shimniok/bot-thoughts-sharpi2c/README.md

A2D converts analog for you and presents it digitally through I2C, SPI or Serial. 
The onboard ATtiny performs oversampling and filtering to reduce noise. Flexible and hackable, 
you can program the device with AVRISP and make use of any of the exposed GPIO pins.
