shimniok/bot-thoughts-sharpi2c/(list of files, cad)

Other CAD files:
i2c_adc/I2C_adc.skp
