shimniok/bot-thoughts-sharpi2c/sharpirfilter/SharpIR Filt.brd

## EAGLE design sharpirfilter/SharpIR Filt.brd (2015-05-10)

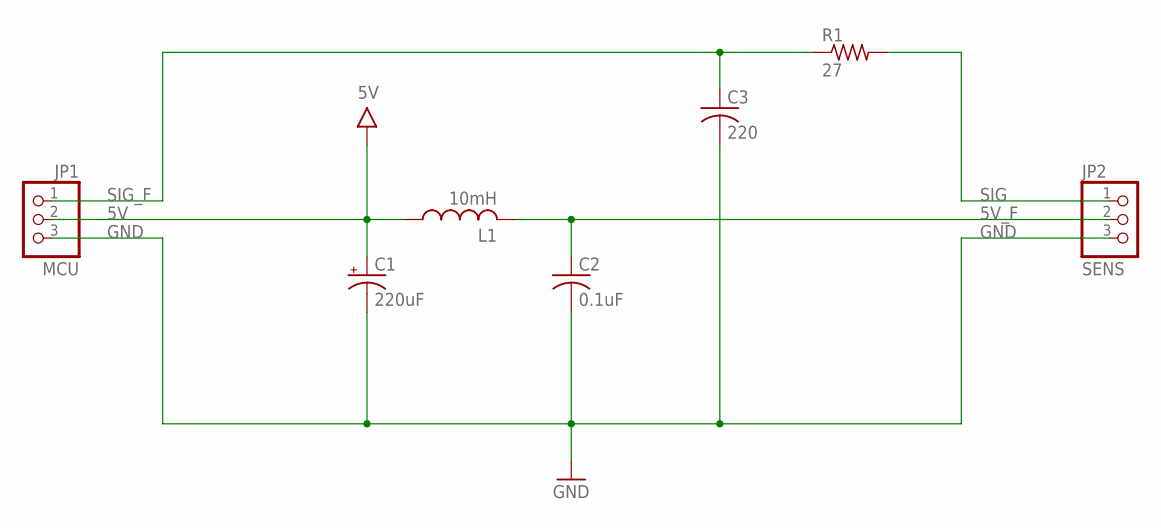
[picture p1: schematic SharpIR Filt.sch]

Parts:
C1: 220uF; PANASONIC_C
C2: 0.1uF; C0603
C3: 220; C0603
JP1: MCU; 1X03M
JP2: SENS; 1X03M
L1: 10mH; L5650M
R1: 27; R0603

Connections:
5V: C1.+, JP1.2, L1.1
5V_F: C2.1, JP2.2, L1.2
GND: C1.-, C2.2, C3.2, JP1.3, JP2.3
SIG: JP2.1, R1.2
SIG_F: C3.1, JP1.1, R1.1

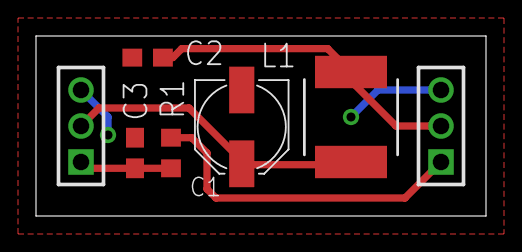
[picture p2: board SharpIR Filt.brd from above]

Board: 2 copper layers, 25.0 x 10.0 mm, 7 parts (0 on the bottom side), 5 nets.
