shimniok/bot-thoughts-sharpi2c/i2c_adc/i2c_adc_avr.brd

## EAGLE design i2c_adc/i2c_adc_avr.brd (2015-05-10)

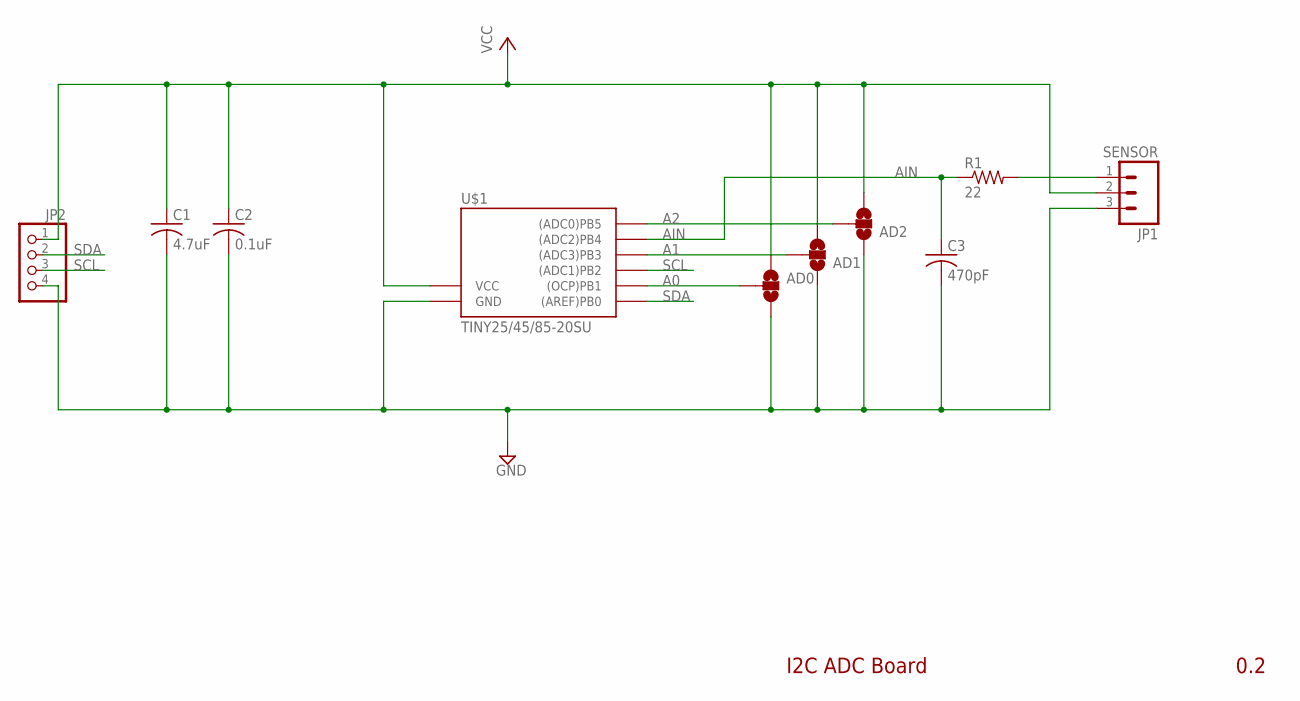
[picture p3: schematic i2c_adc_avr.sch]

Parts:
AD0, AD1, AD2: SOLDERJUMPER_2WAYS; SJ_3
C1: 4.7uF; C0603
C2: 0.1uF; C0603
C3: 470pF; C0603
JP1: SENSOR; 1X03
JP2: PINHD-1X04_2.54-S; 1X04-S
R1: 22; R0603
U$1: TINY25/45/85-20SU; SOIC8

Connections:
A0: AD0.2, U$1.6 ((OCP)PB1)
A1: AD1.2, U$1.2 ((ADC3)PB3)
A2: AD2.2, U$1.1 ((ADC0)PB5)
AIN: C3.1, R1.1, U$1.3 ((ADC2)PB4)
GND: AD0.3, AD1.1, AD2.1, C1.2, C2.2, C3.2, JP1.3, JP2.4, U$1.4 (GND)
unnamed: JP1.1, R1.2
SCL: JP2.3, U$1.7 ((ADC1)PB2)
SDA: JP2.2, U$1.5 ((AREF)PB0)
VCC: AD0.1, AD1.3, AD2.3, C1.1, C2.1, JP1.2, JP2.1, U$1.8 (VCC)

Notes on the sheet:
I2C ADC Board
0.2

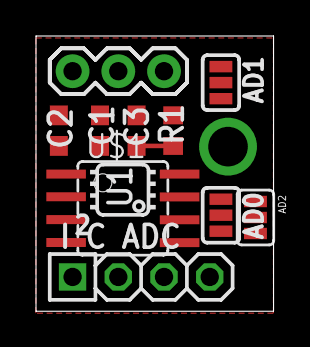
[picture p4: board i2c_adc/i2c_adc_avr.brd from above]

Board: 2 copper layers, 13.2 x 15.3 mm, 10 parts (0 on the bottom side), 9 nets.
