shimniok/bot-thoughts-sharpi2c/i2c_adc/i2c_adc_1.brd

## EAGLE design i2c_adc/i2c_adc_1.brd (2015-05-10)

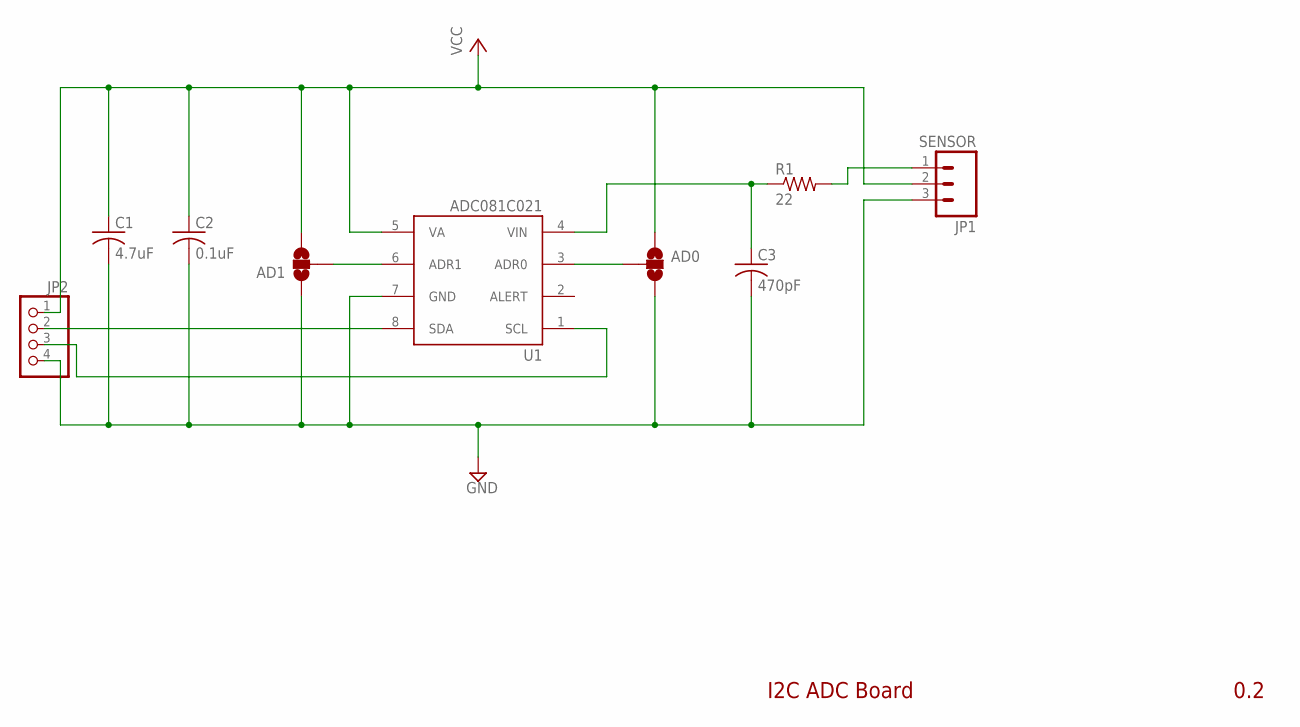
[picture p5: schematic i2c_adc_1.sch]

Parts:
AD0, AD1: SOLDERJUMPER_2WAYS; SJ_3
C1: 4.7uF; C0603
C2: 0.1uF; C0603
C3: 470pF; C0603
JP1: SENSOR; 1X03
JP2: PINHD-1X04_2.54-S; 1X04-S
R1: 22; R0603
U1: ADC081C021; MSOP8_0.65

Connections:
GND: AD0.3, AD1.1, C1.2, C2.2, C3.2, JP1.3, JP2.4, U1.7 (GND)
unnamed: JP1.1, R1.2
unnamed: AD1.2, U1.6 (ADR1)
unnamed: AD0.2, U1.3 (ADR0)
unnamed: C3.1, R1.1, U1.4 (VIN)
SCL: JP2.3, U1.1 (SCL)
SDA: JP2.2, U1.8 (SDA)
VCC: AD0.1, AD1.3, C1.1, C2.1, JP1.2, JP2.1, U1.5 (VA)

Notes on the sheet:
I2C ADC Board
0.2

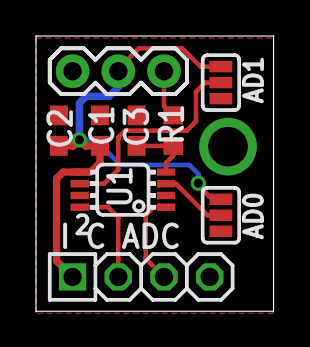
[picture p6: board i2c_adc_1.brd from above]

Board: 2 copper layers, 13.2 x 15.3 mm, 9 parts (0 on the bottom side), 8 nets.
