shimniok/bot-thoughts-sharpi2c/electronics/backplane.brd

## EAGLE design electronics/backplane.brd (2013-08-21)

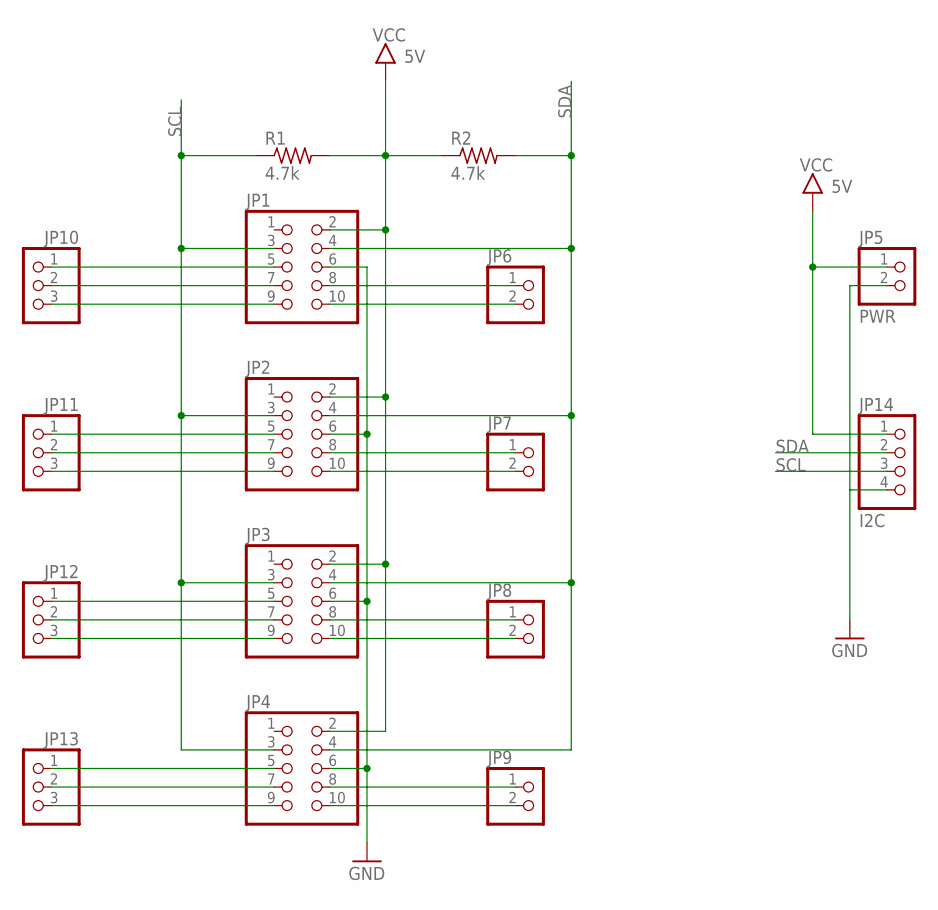
[picture p7: schematic backplane.sch]

Parts:
JP1, JP2, JP3, JP4: PINHD-2X5; 2X05
JP5: PWR; 1X02-S
JP6, JP7, JP8, JP9: PINHD-1X02_2.54-S; 1X02-S
JP10, JP11, JP12, JP13: PINHD-1X03_2.54-S; 1X03-S
JP14: I2C; 1X04-S
R1, R2: 4.7k; R0603

Connections:
GND: JP1.6, JP2.6, JP3.6, JP4.6, JP5.2, JP14.4
unnamed: JP1.5, JP10.1
unnamed: JP1.7, JP10.2
unnamed: JP1.9, JP10.3
unnamed: JP1.8, JP6.1
unnamed: JP2.5, JP11.1
unnamed: JP2.7, JP11.2
unnamed: JP2.9, JP11.3
unnamed: JP3.5, JP12.1
unnamed: JP3.7, JP12.2
unnamed: JP3.9, JP12.3
unnamed: JP4.5, JP13.1
unnamed: JP4.7, JP13.2
unnamed: JP4.9, JP13.3
unnamed: JP1.10, JP6.2
unnamed: JP2.8, JP7.1
unnamed: JP2.10, JP7.2
unnamed: JP3.8, JP8.1
unnamed: JP3.10, JP8.2
unnamed: JP4.8, JP9.1
unnamed: JP4.10, JP9.2
SCL: JP1.3, JP2.3, JP3.3, JP4.3, JP14.3, R1.1
SDA: JP1.4, JP2.4, JP3.4, JP4.4, JP14.2, R2.2
VCC: JP1.2, JP2.2, JP3.2, JP4.2, JP5.1, JP14.1, R1.2, R2.1

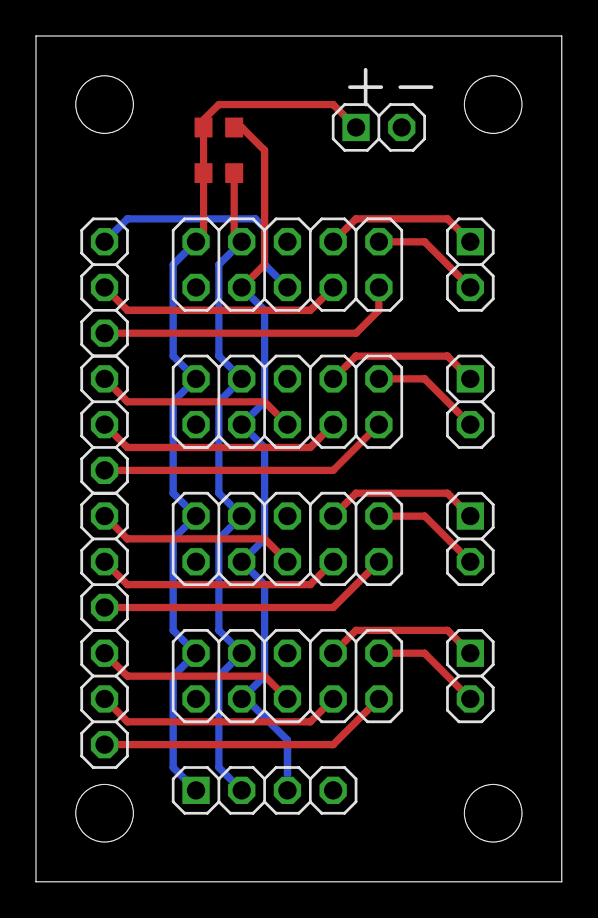
[picture p8: board backplane.brd from above]

Board: 2 copper layers, 29.2 x 47.0 mm, 16 parts (0 on the bottom side), 24 nets.
