shimniok/bot-thoughts-sharpi2c/electronics/i2c_adc_avr_inline_soic_pth.brd

## EAGLE design electronics/i2c_adc_avr_inline_soic_pth.brd (2013-08-21)

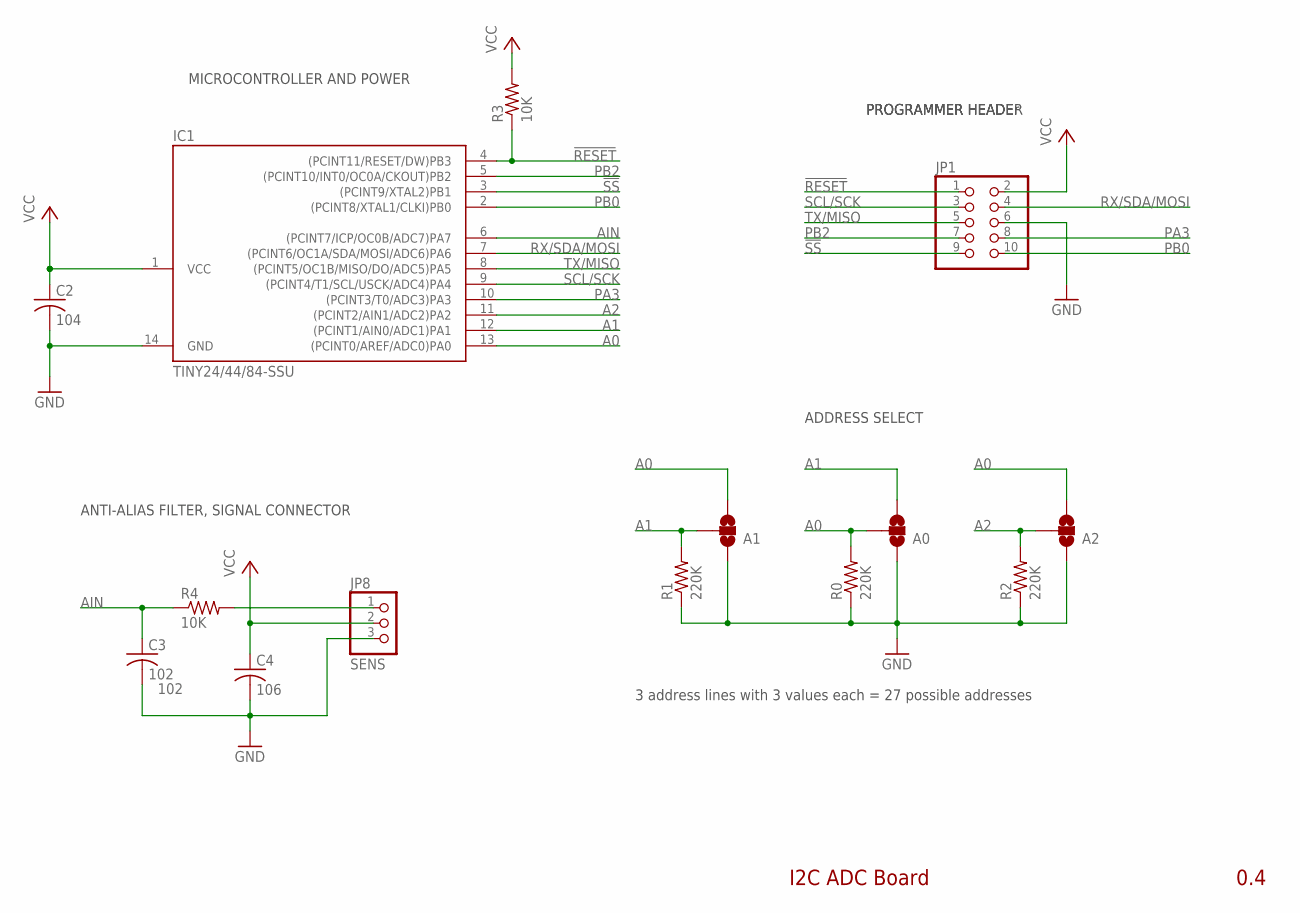
[picture p9: schematic i2c_adc_avr_inline_soic_pth.sch]

Parts:
A0, A1, A2: SJ_3
C2: 104; C0603; PARTNO C1608X7R1E104K080AA
C3: 102; C0603; PARTNO CL10B102KB8SFNC
C4: 106; C0603; PARTNO CL10A106MP8NNNC
IC1: TINY24/44/84-SSU; SOIC14
JP1: PINHD-2X05_2.54-90°; 2X05/90
JP8: SENS; 1X03-S
R0, R1, R2: 220K; R0603; PARTNO RC1608J224CS
R3, R4: 10K; R0603; PARTNO 1622829-1

Connections:
!RESET: IC1.4 ((PCINT11/RESET/DW)PB3), JP1.1, R3.1
!SS: IC1.3 ((PCINT9/XTAL2)PB1), JP1.9
A0: A0.2, A1.3, A2.3, IC1.13 ((PCINT0/AREF/ADC0)PA0), R0.2
A1: A0.3, A1.2, IC1.12 ((PCINT1/AIN0/ADC1)PA1), R1.2
A2: A2.2, IC1.11 ((PCINT2/AIN1/ADC2)PA2), R2.2
AIN: C3.1, IC1.6 ((PCINT7/ICP/OC0B/ADC7)PA7), R4.1
GND: A0.1, A1.1, A2.1, C2.2, C3.2, C4.2, IC1.14 (GND), JP1.6, JP8.3, R0.1, R1.1, R2.1
unnamed: JP8.1, R4.2
PA3: IC1.10 ((PCINT3/T0/ADC3)PA3), JP1.8
PB0: IC1.2 ((PCINT8/XTAL1/CLKI)PB0), JP1.10
PB2: IC1.5 ((PCINT10/INT0/OC0A/CKOUT)PB2), JP1.7
RX/SDA/MOSI: IC1.7 ((PCINT6/OC1A/SDA/MOSI/ADC6)PA6), JP1.4
SCL/SCK: IC1.9 ((PCINT4/T1/SCL/USCK/ADC4)PA4), JP1.3
TX/MISO: IC1.8 ((PCINT5/OC1B/MISO/DO/ADC5)PA5), JP1.5
VCC: C2.1, C4.1, IC1.1 (VCC), JP1.2, JP8.2, R3.2

Notes on the sheet:
I2C ADC Board
0.4
ADDRESS SELECT
MICROCONTROLLER AND POWER
ANTI-ALIAS FILTER, SIGNAL CONNECTOR
3 address lines with 3 values each = 27 possible addresses
PROGRAMMER HEADEr
PROGRAMMER HEADER

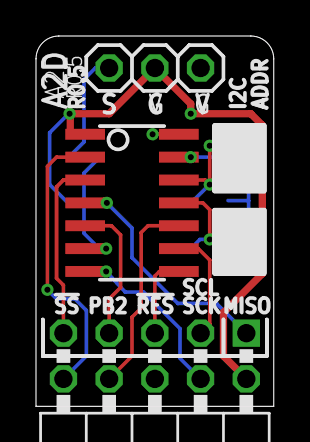
[picture p10: board i2c_adc_avr_inline_soic_pth.brd from above]

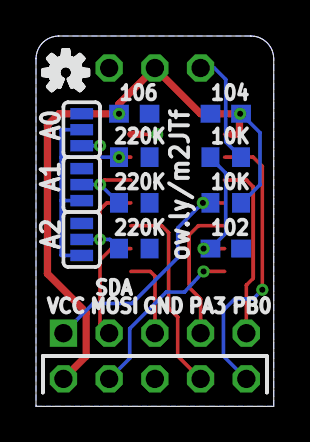
[picture p11: board i2c_adc_avr_inline_soic_pth.brd from below]

Board: 2 copper layers, 13.2 x 20.6 mm, 14 parts (11 on the bottom side), 15 nets.
