shimniok/bot-thoughts-sharpi2c/electronics/i2c_adc_avr_inline_soic.brd

## EAGLE design electronics/i2c_adc_avr_inline_soic.brd (2013-08-21)

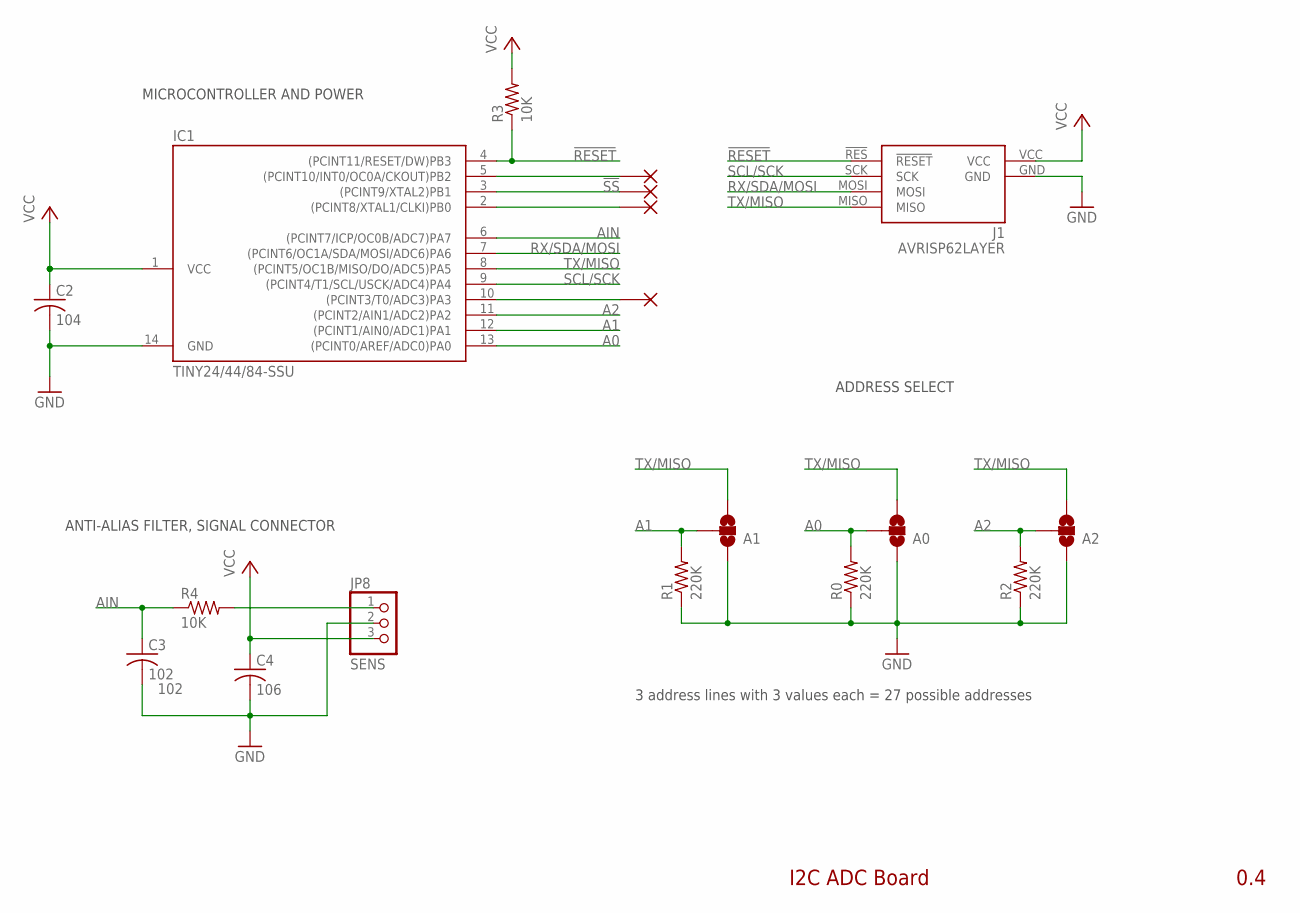
[picture p12: schematic i2c_adc_avr_inline_soic.sch]

Parts:
A0, A1, A2: SJ_3
C2: 104; C0603; PARTNO C1608X7R1E104K080AA
C3: 102; C0603; PARTNO CL10B102KB8SFNC
C4: 106; C0603; PARTNO CL10A106MP8NNNC
IC1: TINY24/44/84-SSU; SOIC14
J1: AVRISP62LAYER; 2X3_2LAYER
JP8: SENS; 1X03-S
R0, R1, R2: 220K; R0603; PARTNO RC1608J224CS
R3, R4: 10K; R0603; PARTNO 1622829-1
X1: PB2; PAD0.07X0.15
X2: !SS; PAD0.07X0.15
X3: PB0; PAD0.07X0.15
X4: PA3; PAD0.07X0.15

Connections:
!RESET: IC1.4 ((PCINT11/RESET/DW)PB3), J1.!RES (!RESET), R3.1
!SS: IC1.3 ((PCINT9/XTAL2)PB1), X2.P$1
A0: A0.2, IC1.13 ((PCINT0/AREF/ADC0)PA0), R0.2
A1: A1.2, IC1.12 ((PCINT1/AIN0/ADC1)PA1), R1.2
A2: A2.2, IC1.11 ((PCINT2/AIN1/ADC2)PA2), R2.2
AIN: C3.1, IC1.6 ((PCINT7/ICP/OC0B/ADC7)PA7), R4.1
GND: A0.1, A1.1, A2.1, C2.2, C3.2, C4.2, IC1.14 (GND), J1.GND, JP8.2, R0.1, R1.1, R2.1
unnamed: JP8.1, R4.2
unnamed: IC1.10 ((PCINT3/T0/ADC3)PA3), X4.P$1
unnamed: IC1.2 ((PCINT8/XTAL1/CLKI)PB0), X3.P$1
unnamed: IC1.5 ((PCINT10/INT0/OC0A/CKOUT)PB2), X1.P$1
RX/SDA/MOSI: IC1.7 ((PCINT6/OC1A/SDA/MOSI/ADC6)PA6), J1.MOSI
SCL/SCK: IC1.9 ((PCINT4/T1/SCL/USCK/ADC4)PA4), J1.SCK
TX/MISO: A0.3, A1.3, A2.3, IC1.8 ((PCINT5/OC1B/MISO/DO/ADC5)PA5), J1.MISO
VCC: C2.1, C4.1, IC1.1 (VCC), J1.VCC, JP8.3, R3.2

Notes on the sheet:
I2C ADC Board
0.4
ADDRESS SELECT
MICROCONTROLLER AND POWER
ANTI-ALIAS FILTER, SIGNAL CONNECTOR
3 address lines with 3 values each = 27 possible addresses

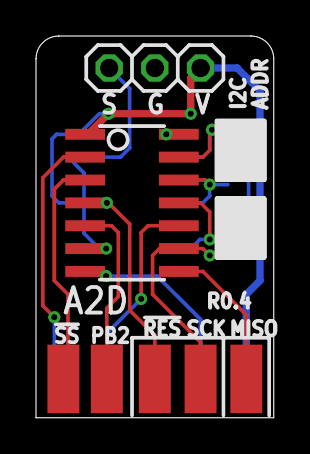
[picture p13: board i2c_adc_avr_inline_soic.brd from above]

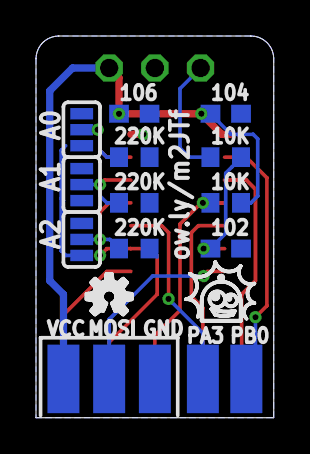
[picture p14: board i2c_adc_avr_inline_soic.brd from below]

Board: 2 copper layers, 13.2 x 21.2 mm, 18 parts (13 on the bottom side), 15 nets.
