shimniok/bot-thoughts-sharpi2c/electronics/i2c_adc_avr_inline.brd

## EAGLE design electronics/i2c_adc_avr_inline.brd (2013-08-07)

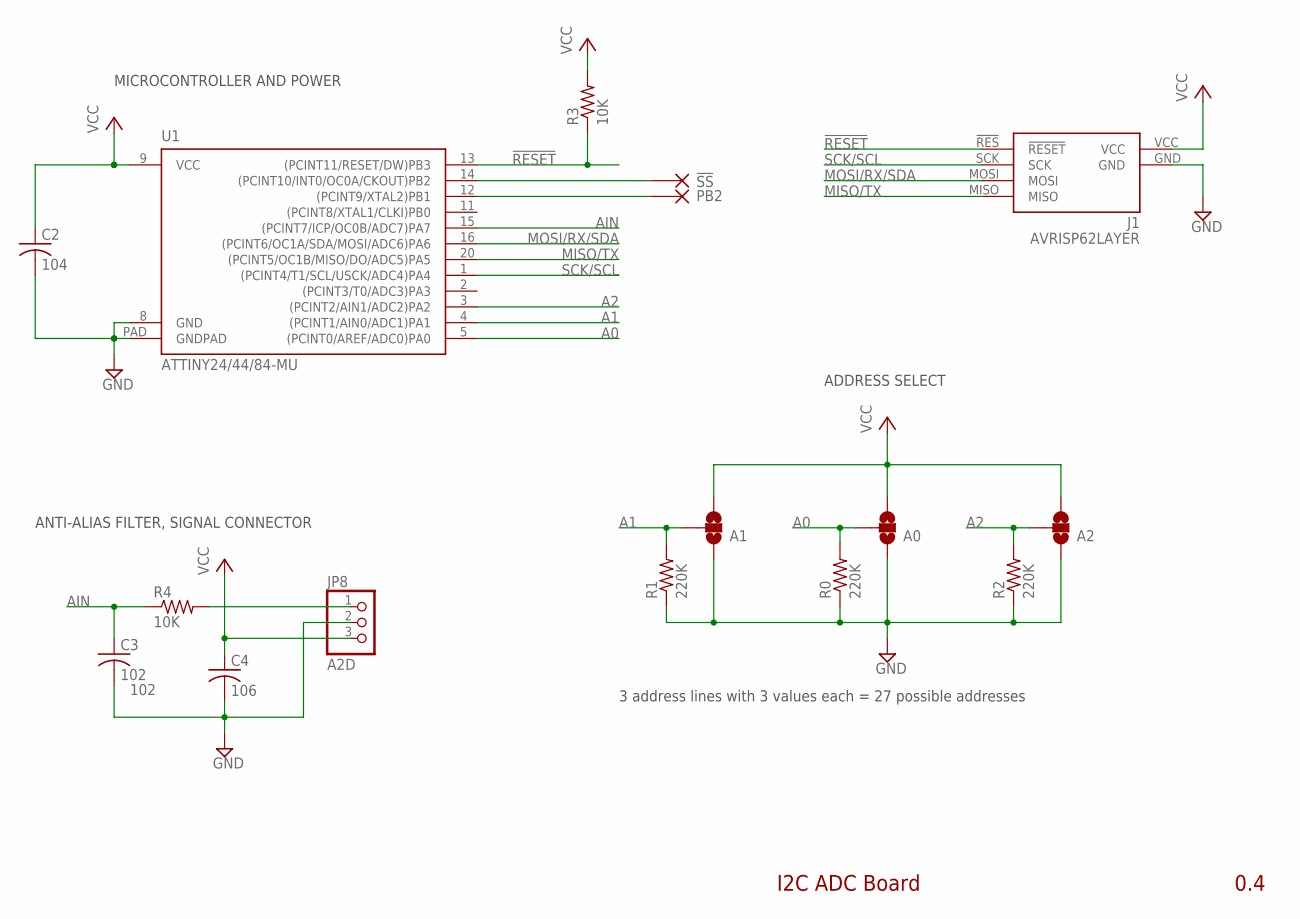
[picture p15: schematic i2c_adc_avr_inline.sch]

Parts:
A0, A1, A2: SJ_3
C2: 104; C0603; PARTNO C1608X7R1E104K080AA
C3: 102; C0603; PARTNO CL10B102KB8SFNC
C4: 106; C0603; PARTNO CL10A106MP8NNNC
J1: AVRISP62LAYER; 2X3_2LAYER
JP8: A2D; 1X03-S
R0, R1, R2: 220K; R0603; PARTNO RC1608J224CS
R3, R4: 10K; R0603; PARTNO 1622829-1
U1: ATTINY24/44/84-MU; 20MLF_0.5
X1: !SS; PAD0.07X0.15
X4: PB2; PAD0.07X0.15

Connections:
!RESET: J1.!RES (!RESET), R3.1, U1.13 ((PCINT11/RESET/DW)PB3)
A0: A0.2, R0.2, U1.5 ((PCINT0/AREF/ADC0)PA0)
A1: A1.2, R1.2, U1.4 ((PCINT1/AIN0/ADC1)PA1)
A2: A2.2, R2.2, U1.3 ((PCINT2/AIN1/ADC2)PA2)
AIN: C3.1, R4.1, U1.15 ((PCINT7/ICP/OC0B/ADC7)PA7)
GND: A0.1, A1.1, A2.1, C2.2, C3.2, C4.2, J1.GND, JP8.2, R0.1, R1.1, R2.1, U1.8 (GND), U1.PAD (GNDPAD)
MISO/TX: J1.MISO, U1.20 ((PCINT5/OC1B/MISO/DO/ADC5)PA5)
MOSI/RX/SDA: J1.MOSI, U1.16 ((PCINT6/OC1A/SDA/MOSI/ADC6)PA6)
unnamed: JP8.1, R4.2
unnamed: U1.14 ((PCINT10/INT0/OC0A/CKOUT)PB2), X1.P$1
unnamed: U1.12 ((PCINT9/XTAL2)PB1), X4.P$1
SCK/SCL: J1.SCK, U1.1 ((PCINT4/T1/SCL/USCK/ADC4)PA4)
VCC: A0.3, A1.3, A2.3, C2.1, C4.1, J1.VCC, JP8.3, R3.2, U1.9 (VCC)

Notes on the sheet:
I2C ADC Board
0.4
ADDRESS SELECT
MICROCONTROLLER AND POWER
ANTI-ALIAS FILTER, SIGNAL CONNECTOR
3 address lines with 3 values each = 27 possible addresses

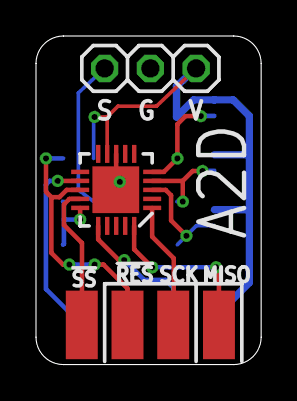
[picture p16: board i2c_adc_avr_inline.brd from above]

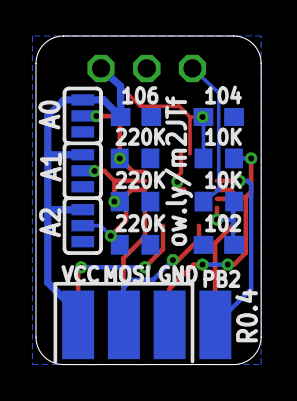
[picture p17: board i2c_adc_avr_inline.brd from below]

Board: 2 copper layers, 12.5 x 18.3 mm, 16 parts (12 on the bottom side), 13 nets.
