shimniok/bot-thoughts-sharpi2c/electronics/i2c_adc_avr.brd

## EAGLE design electronics/i2c_adc_avr.brd (2013-08-07)

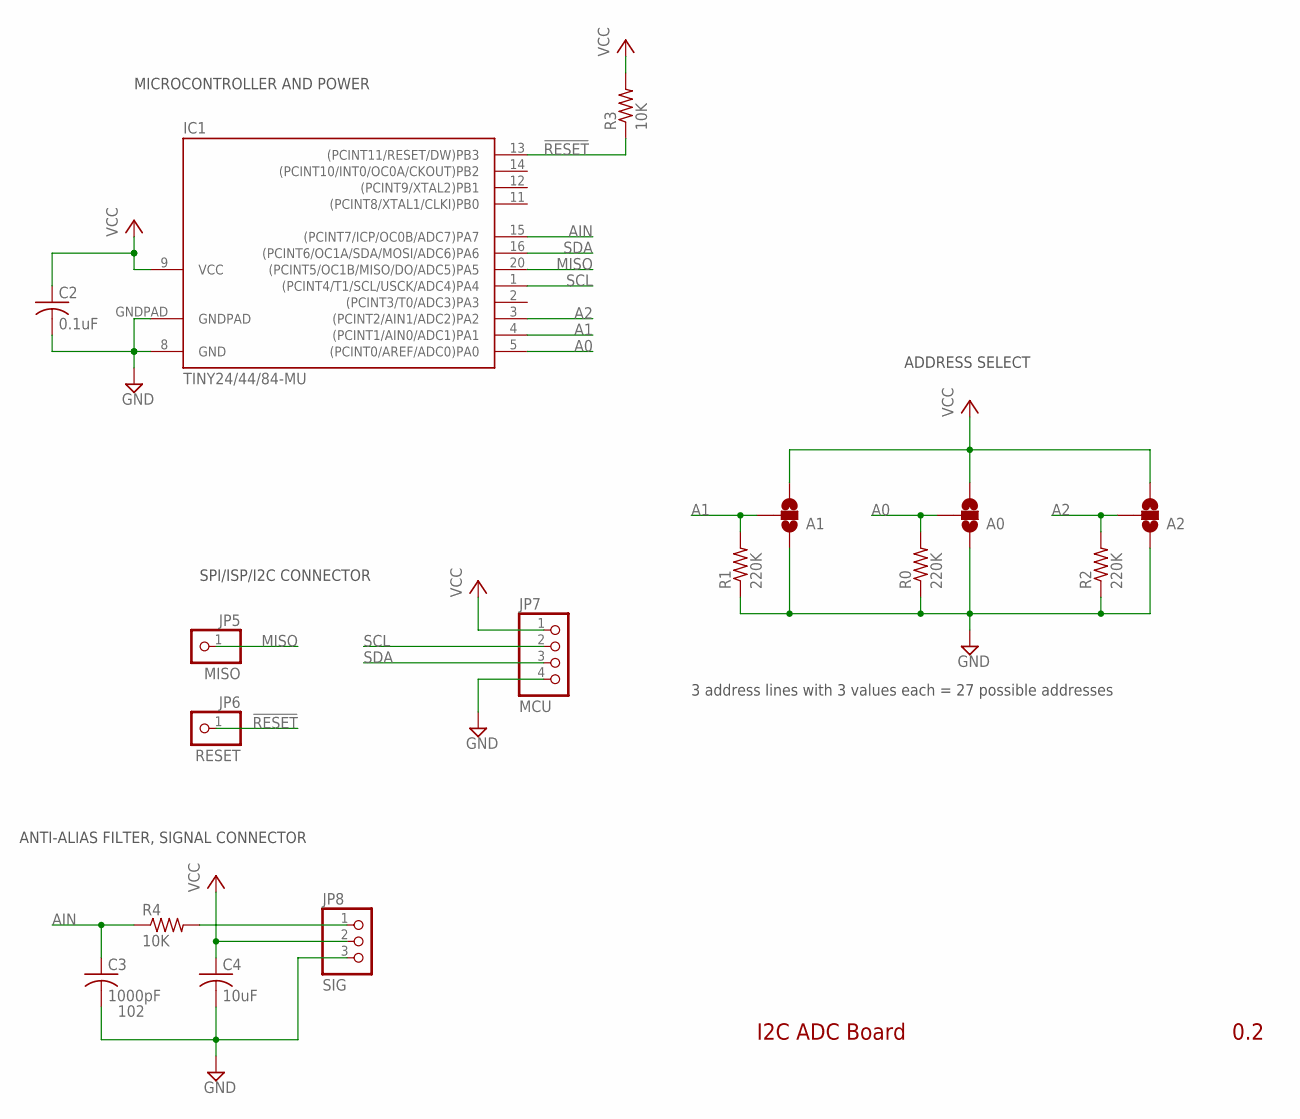
[picture p18: schematic i2c_adc_avr.sch]

Parts:
A0, A1, A2: SJ_3
C2: 0.1uF; C0603; PARTNO C1608X7R1E104K080AA
C3: 1000pF; C0603; PARTNO CL10B102KB8SFNC
C4: 10uF; C0603; PARTNO CL10A106MP8NNNC
IC1: TINY24/44/84-MU; QFN/MLF20; PARTNO ATTINY44A-MU
JP5: MISO; 1X01
JP6: RESET; 1X01
JP7: MCU; 1X04-S
JP8: SIG; 1X03M
R0, R1, R2: 220K; R0603; PARTNO RC1608J224CS
R3, R4: 10K; R0603; PARTNO 1622829-1

Connections:
!RESET: IC1.13 ((PCINT11/RESET/DW)PB3), JP6.1, R3.1
A0: A0.2, IC1.5 ((PCINT0/AREF/ADC0)PA0), R0.2
A1: A1.2, IC1.4 ((PCINT1/AIN0/ADC1)PA1), R1.2
A2: A2.2, IC1.3 ((PCINT2/AIN1/ADC2)PA2), R2.2
AIN: C3.1, IC1.15 ((PCINT7/ICP/OC0B/ADC7)PA7), R4.1
GND: A0.1, A1.1, A2.1, C2.2, C3.2, C4.2, IC1.8 (GND), IC1.GNDPAD, JP7.4, JP8.3, R0.1, R1.1, R2.1
MISO: IC1.20 ((PCINT5/OC1B/MISO/DO/ADC5)PA5), JP5.1
unnamed: JP8.1, R4.2
SCL: IC1.1 ((PCINT4/T1/SCL/USCK/ADC4)PA4), JP7.2
SDA: IC1.16 ((PCINT6/OC1A/SDA/MOSI/ADC6)PA6), JP7.3
VCC: A0.3, A1.3, A2.3, C2.1, C4.1, IC1.9 (VCC), JP7.1, JP8.2, R3.2

Notes on the sheet:
I2C ADC Board
0.2
ADDRESS SELECT
MICROCONTROLLER AND POWER
ANTI-ALIAS FILTER, SIGNAL CONNECTOR
SPI/ISP/I2C CONNECTOR
3 address lines with 3 values each = 27 possible addresses

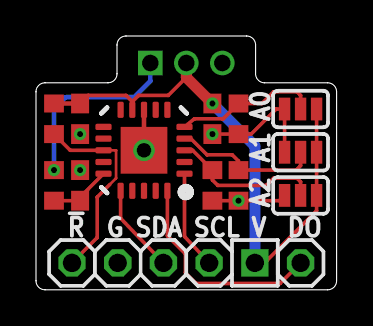
[picture p19: board electronics/i2c_adc_avr.brd from above]

Board: 2 copper layers, 16.7 x 14.1 mm, 16 parts (1 on the bottom side), 11 nets.
