shimniok/bot-thoughts-sharpi2c/electronics/I2C_IR.brd

## EAGLE design electronics/I2C_IR.brd (2013-02-04)

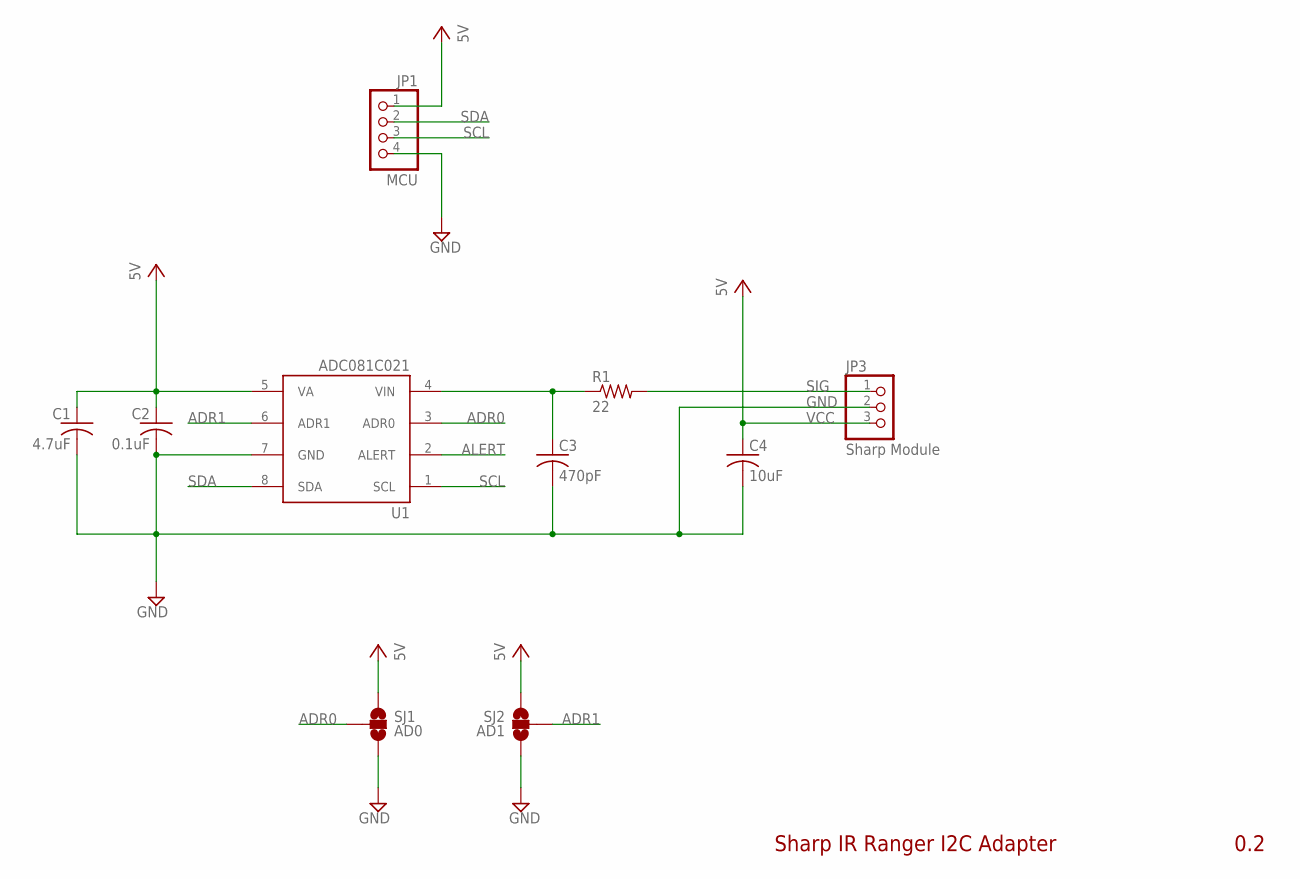
[picture p20: schematic I2C_IR.sch]

Parts:
C1: 4.7uF; C0805K; PARTNO T491A475K010AT
C2: 0.1uF; C0603
C3: 470pF; C0603
C4: 10uF; C0805K
JP1: MCU; 1X04-S
JP3: Sharp Module; 1X03M
R1: 22; R0603
SJ1: AD0; SJ_3
SJ2: AD1; SJ_3
U1: ADC081C021; MSOP8_0.65

Connections:
ADR0: SJ1.2, U1.3 (ADR0)
ADR1: SJ2.2, U1.6 (ADR1)
ALERT: U1.2 (ALERT)
GND: C1.2, C2.2, C3.2, C4.2, JP1.4, JP3.2, SJ1.3, SJ2.3, U1.7 (GND)
unnamed: C3.1, R1.1, U1.4 (VIN)
SCL: JP1.3, U1.1 (SCL)
SDA: JP1.2, U1.8 (SDA)
SIG: JP3.1, R1.2
VCC: C1.1, C2.1, C4.1, JP1.1, JP3.3, SJ1.1, SJ2.1, U1.5 (VA)

Notes on the sheet:
Sharp IR Ranger I2C Adapter
0.2
