shimniok/bot-thoughts-sharpi2c/electronics/I2C_IR.brd

## EAGLE design electronics/I2C_IR.brd (continued)

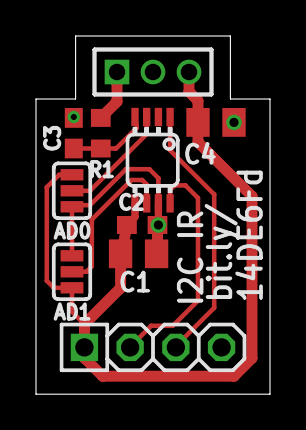
[picture p21: board I2C_IR.brd from above]

Board: 2 copper layers, 13.0 x 19.9 mm, 10 parts (0 on the bottom side), 8 nets.
