shimniok/bot-thoughts-sharpi2c/software/A2D/include/adc.h

/*
 * adc.h
 *
 *  Created on: Jun 18, 2013
 *      Author: mes
 */

#ifndef ADC_H_
#define ADC_H_

#include <stdint.h>

#define ADCRES 10 // our adc resolution is 10 bit

void adc_init();
uint16_t adc_result();
uint16_t adc_get_m();
uint16_t adc_get_n();
void adc_set_n(uint16_t new_n);

#endif /* ADC_H_ */
