shimniok/bot-thoughts-sharpi2c/software/A2D/include/addr.h

/*
 * addr.h
 *
 *  Created on: Jun 18, 2013
 *      Author: mes
 */

#ifndef ADDR_H_
#define ADDR_H_

#define ADDR_DDR DDRA
#define ADDR_PORT PORTA
#define ADDR_PIN PINA

#define ADDR2 PA2
#define ADDR1 PA1
#define ADDR0 PA0

uint8_t get_address();

#endif /* ADDR_H_ */
