shimniok/bot-thoughts-sharpi2c/software/USI_Serial/include/usi_uart.h

/*
 * print.h
 *
 *  Created on: Jun 12, 2013
 *      Author: ???
 */

#ifndef __USI_UART_H__
#define __USI_UART_H__

//USI UART DEFINES

//********** USI UART Defines **********//

//#define BAUDRATE                   115200
//#define BAUDRATE                    57600
//#define BAUDRATE                    28800
//#define BAUDRATE                    19200
//#define BAUDRATE                    14400
#define BAUDRATE                     9600

//#define TIMER_PRESCALER           1
#define TIMER_PRESCALER            8
#define TIMER_PRESCALER_BITS	   (0<<CS02)|(1<<CS01)|(0<<CS00)

#define UART_RX_BUFFER_SIZE        4     /* 2,4,8,16,32,64,128 or 256 bytes */
#define UART_TX_BUFFER_SIZE        4


//********** USI_UART Prototypes **********//

unsigned char Bit_Reverse( unsigned char );
void          USI_UART_Flush_Buffers( void );
void          USI_UART_Initialise_Receiver( void );
void          USI_UART_Initialise_Transmitter( void );
void          USI_UART_Transmit_Byte( unsigned char );
unsigned char USI_UART_Receive_Byte( void );
unsigned char USI_UART_Data_In_Receive_Buffer( void );

#endif
