shimniok/bot-thoughts-sharpi2c/(commit log)

2013-02-01 Initial revision
    [I2C_IR.brd, I2C_IR.sch]
2013-02-01 Revised board layout
    [I2C_IR.brd, I2C_IR.sch]
2013-02-01 Revised board layout per datasheet, single ground plane with join at chip ground location, no bottom traces, use tantalum bypass caps, etc.
    [I2C_IR.brd, I2C_IR.sch]
2013-02-01 Minor layout tweaks
    [I2C_IR.brd]
2013-02-04 Revised board layout removing 'cut' per white paper I read.
    [I2C_IR.brd]
2013-06-14 Early revision of AVR based I2C adapter
    [i2c_adc_avr.brd, i2c_adc_avr.sch]
2013-06-14 Initial revisions for serial and I2C solutions.
2013-06-19 Rev 0.3 as built (version is mislabeled on silk)
    [i2c_adc_avr.brd, i2c_adc_avr.sch]
2013-06-19 Separated adc, filter into modules. Added address module for determining address from solder jumpers, started code for distance conversion, revised how registers / parameters are updated through I2C.
2013-08-07 A2D soic as ordered, migrated to soic, added silk spots for writing address, moved lots around, changed end connector exposed more pins
    [i2c_adc_avr_inline_soic.brd, i2c_adc_avr_inline_soic.sch]
2013-08-07 Changed footprint, layout
    [i2c_adc_avr.brd, i2c_adc_avr.sch]
2013-08-07 Minor changes to i2cadc project
2013-08-07 Updated version of the inline with QFN, moved layout, added !SS and PB2 pins, using 2-side pads for connectors
    [i2c_adc_avr_inline.brd, i2c_adc_avr_inline.sch]
2013-08-21 Modified layouts, routing.
    [i2c_adc_avr_inline_soic.brd, i2c_adc_avr_inline_soic.sch]
2013-08-21 PTH connector version with some additional fixes
    [i2c_adc_avr_inline_soic_pth.brd, i2c_adc_avr_inline_soic_pth.sch]
2013-08-21 Initial version of backplane idea
    [backplane.brd, backplane.sch]
2013-08-21 Initial revision of USI I2C library
2013-08-21 Renamed i2cadc to A2Di2c
2013-08-21 Added makefiles, tweaked adc code to use registers
2015-05-10 Added I2C ADC board
    [i2c_adc_1.brd, i2c_adc_1.sch, i2c_adc_avr.brd, i2c_adc_avr.sch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]
2015-05-10 Added I2C ADC sketchup and zip
    [I2C_adc.skp]
2015-05-10 Added sharp IR filter electronics
    [SharpIR Filt.brd, SharpIR Filt.sch]
2015-05-10 Added notes files
    [A2DCutoffFreq.ods]
