shimniok/bot-thoughts-sharpi2c/(notices)

Notices in the files:
software/USI_I2C/usiTwiSlave.c:
This program is free software; you can redistribute it and/or modify it under the
terms of the GNU General Public License as published by the Free Software
parts and their libraries:
SparkFun: Licensing: CC v3.0 Share-Alike You are welcome to use this library for commercial purposes.
